ivan-gluscic101/Sound-Localization-Based-On-A-Microphone-Array/Sound Localization/Sound Localization.ioc

Mcu.UserName=STM32G474RETx
PA13.GPIO_Label=T_SWDIO
PA13.Signal=SYS_JTMS-SWDIO
PA14.GPIO_Label=T_SWCLK
PA14.Signal=SYS_JTCK-SWCLK
PA2.Signal=LPUART1_TX
PA3.Signal=LPUART1_RX
PA5.Signal=GPIO_Output
PB14.Signal=ADC1_IN5
PB3.GPIO_Label=T_SWO
PB3.Signal=SYS_JTDO-SWO
PB8-BOOT0.Signal=I2C1_SCL
PB9.Signal=I2C1_SDA
PC0.Signal=ADC1_IN6
PC1.Signal=ADC1_IN7
PC10.Signal=UART4_TX
PC11.Signal=UART4_RX
PC13.Signal=GPXTI13
PC14-OSC32_IN.GPIO_Label=RCC_OSC32_IN
PC14-OSC32_IN.Signal=RCC_OSC32_IN
PC15-OSC32_OUT.GPIO_Label=RCC_OSC32_OUT
PC15-OSC32_OUT.Signal=RCC_OSC32_OUT
PC2.Signal=ADC1_IN8
PF0-OSC_IN.GPIO_Label=RCC_OSC_IN
PF0-OSC_IN.Signal=RCC_OSC_IN
PF1-OSC_OUT.GPIO_Label=RCC_OSC_OUT
PF1-OSC_OUT.Signal=RCC_OSC_OUT
