ivan-gluscic101/Sound-Localization-Based-On-A-Microphone-Array/ESP32_Visualization/components/Inc/uart_driver.h

#ifndef UART_DRIVER_H
#define UART_DRIVER_H

#include <stdint.h>
#include "driver/uart.h"

/* ESP32 pin configuration */
#define UART_PORT_NUM       UART_NUM_1
#define UART_TX_PIN         (17)
#define UART_RX_PIN         (16)
#define UART_BUF_SIZE       (1024)
#define UART_BAUD_RATE      (115200)

/* Packet markers (same as STM32 side) */
#define ANGLE_PKT_SOF1      0xAA
#define ANGLE_PKT_SOF2      0xBB
#define ANGLE_PKT_TYPE_2D   0x02  /* [AZ_H][AZ_L][STR] */
#define ANGLE_PKT_TYPE_3D   0x03  /* [AZ_H][AZ_L][EL_H][EL_L][STR] */
#define ANGLE_PKT_TYPE_RAW  0x04  /* [NCH][N_H][N_L] + NCH*N*uint16 (big-endian) */
#define ANGLE_PKT_TYPE_ORI  0x05  /* [RL_H][RL_L][PT_H][PT_L][YW_H][YW_L][FLAGS] (IMU orientation) */
#define ANGLE_PKT_EOF1      0xCC
#define ANGLE_PKT_EOF2      0xDD
#define ANGLE_PKT_LEN_2D    8
#define ANGLE_PKT_LEN_3D    10
#define ANGLE_PKT_LEN_ORI   12

/* Raw capture upper bound (RX buffer guard); must cover STM32 SAMPLES_PER_CHANNEL * NUM_CH. */
#define RAW_MAX_CH          4
#define RAW_MAX_SAMPLES     1024
#define RAW_MAX_BYTES       (RAW_MAX_CH * RAW_MAX_SAMPLES * 2)

/* Init UART peripheral for STM32 communication. */
void uart_driver_init(void);

#endif // UART_DRIVER_H
