ivan-gluscic101/Sound-Localization-Based-On-A-Microphone-Array/Sound Localization/Core/CustomDriverSet/SrcDriver/dma_driver.c

#include "dma_driver.h"

/* Enable DMA1/DMAMUX clocks and DMA1 channel 1 interrupt. */
void Custom_DMA_Init(void)
{
    LL_AHB1_GRP1_EnableClock(LL_AHB1_GRP1_PERIPH_DMAMUX1);
    LL_AHB1_GRP1_EnableClock(LL_AHB1_GRP1_PERIPH_DMA1);

    NVIC_SetPriority(DMA1_Channel1_IRQn, NVIC_EncodePriority(NVIC_GetPriorityGrouping(), 5, 0));
    NVIC_EnableIRQ(DMA1_Channel1_IRQn);
}
